disarmyouwitha/zenR4-pcb/projects/README.md

# Active project: Nano Independent

The owner is pursuing a spare original PCB from Darryl for the Zen repair. Integrated replacement development is set aside. Our active design is a nice!nano keyboard and a new case, inspired by the Zen geometry.

- **[Draft B — actual routed boards, revised outline](nano-independent/draft-b/README.md)**
- [Nice!nano project direction](nano-independent/README.md)
- [Current ChatGPT handoff](../docs/CHATGPT-HANDOFF.md)
- [Shared future flash/RGB/display plan](shared/FEATURES.md)

Draft A remains unchanged under `../r4-layout/` and tag `draft-a-baseline`. Draft B changes the outer board edges only; it does not claim the new display/RGB circuitry or new case is finished.
