disarmyouwitha/zenR4-pcb/ATTRIBUTION.md

# Attribution and third-party material

- Original Corne-ish Zen CAD: Thingiverse user **darryldh**, https://www.thingiverse.com/thing:4698210 . The downloaded license states **Creative Commons — Attribution — Non-Commercial — No Derivatives**. Its supplied license and README are retained in `references/zen-original/`, with a copy under `LICENSES/`. Modified base files are personal prototype studies; this private backup does not assert permission for their public redistribution. Review the source terms before publishing this repository.
- KiCad standard footprints and the local `__NoSilk` derivatives: supplied KiCad libraries, with the library license and exception retained in `LICENSES/kicad-footprints-LICENSE.md`. Pad and courtyard geometry of these standard-footprint derivatives was retained; crowded silkscreen was removed.
- Choc socket reference shape: foostan/crkbd and associated kbd footprint sources. Retained reference footprint and the downloaded source notices are under `r4-layout/evidence/`. This project uses a custom Choc V1 socket pattern and derived courtyard; retain the supplied notices.
- Typeractive's model and pinout were earlier research references. This project does not claim Typeractive's PCB source was released or that these custom boards are that product.
- nice!nano/nice!view are referenced products of nice!keyboards; this is an independent carrier prototype.

No blanket license is assigned to all repository content. Source notices remain applicable to their respective files. Private visibility is the initial sharing setting, not an assertion of open-hardware licensing.
