disarmyouwitha/zenR4-pcb/docs/START-HERE.md

# Current packet: Draft-Corne C

Unpack `draft-corne.zip`. Upload `docs/CHATGPT-HANDOFF.md`, `projects/choc-corne-flash/draft-c/README.md`, `validation.json`, and `placement-preview.png` to the next ChatGPT conversation. Native KiCad schematics/boards and local libraries are included for detailed review.

Prompt: “Help review Draft-Corne: 42-key Choc Corne, our tested matrix, front-mounted nice!nanos with components down, left QSPI, right nice!view, battery solder pads on the back. Read the validation report; routing is complete and assembly fit remains unverified. Preserve the tested GPIO map.”

GitHub is private and another session may need uploaded files. Older A/B packets are historical.
