disarmyouwitha/zenR4-pcb/docs/images/01-layout-annotated.png

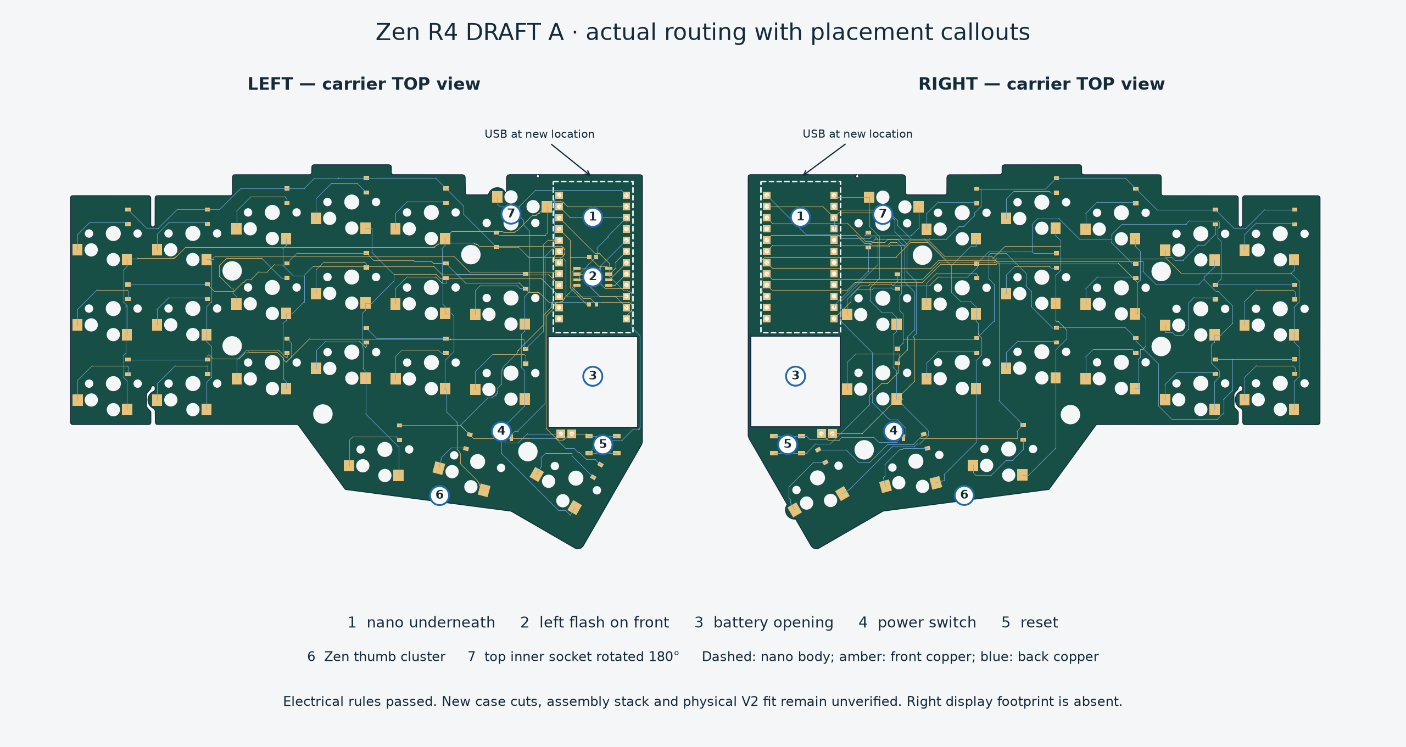
docs/images/01-layout-annotated.png
