disarmyouwitha/zenR4-pcb/docs/images/02-system-and-power.png

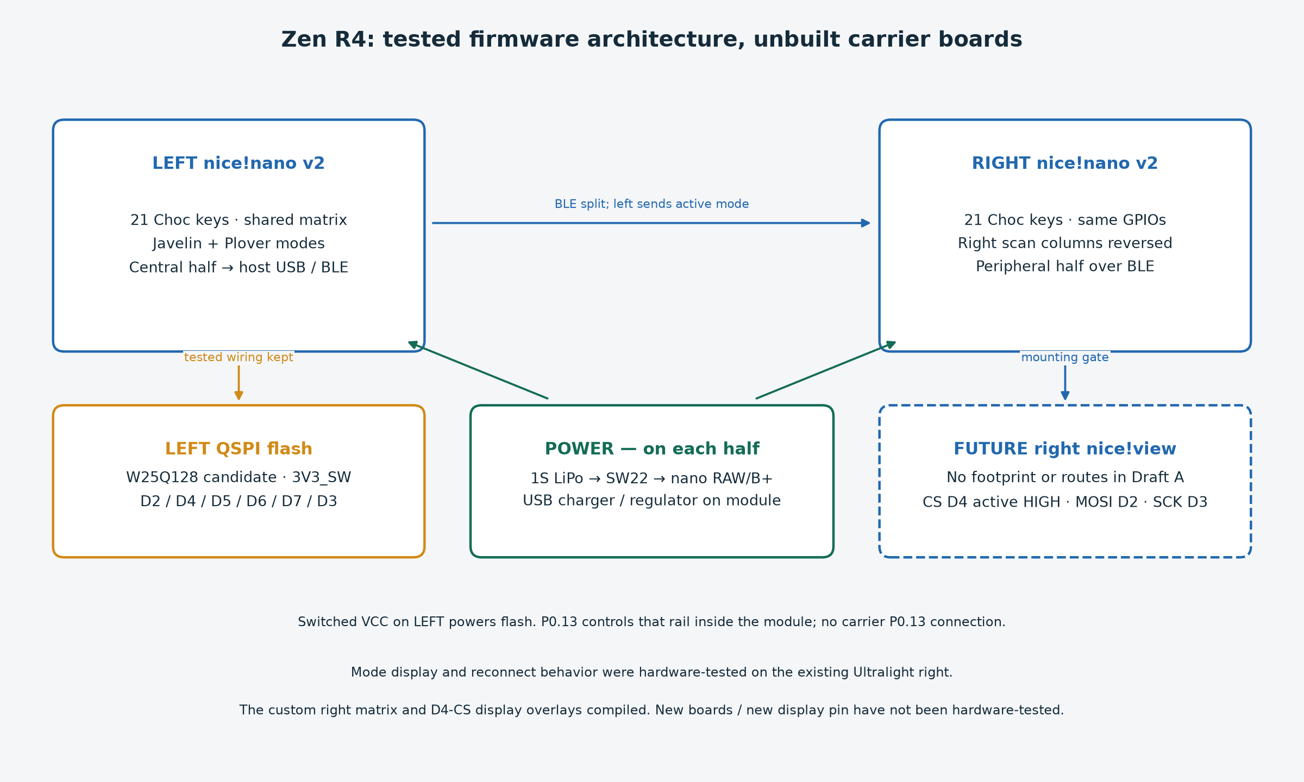
docs/images/02-system-and-power.png
