disarmyouwitha/zenR4-pcb/docs/images/03-nano-top-view-pinmap.png

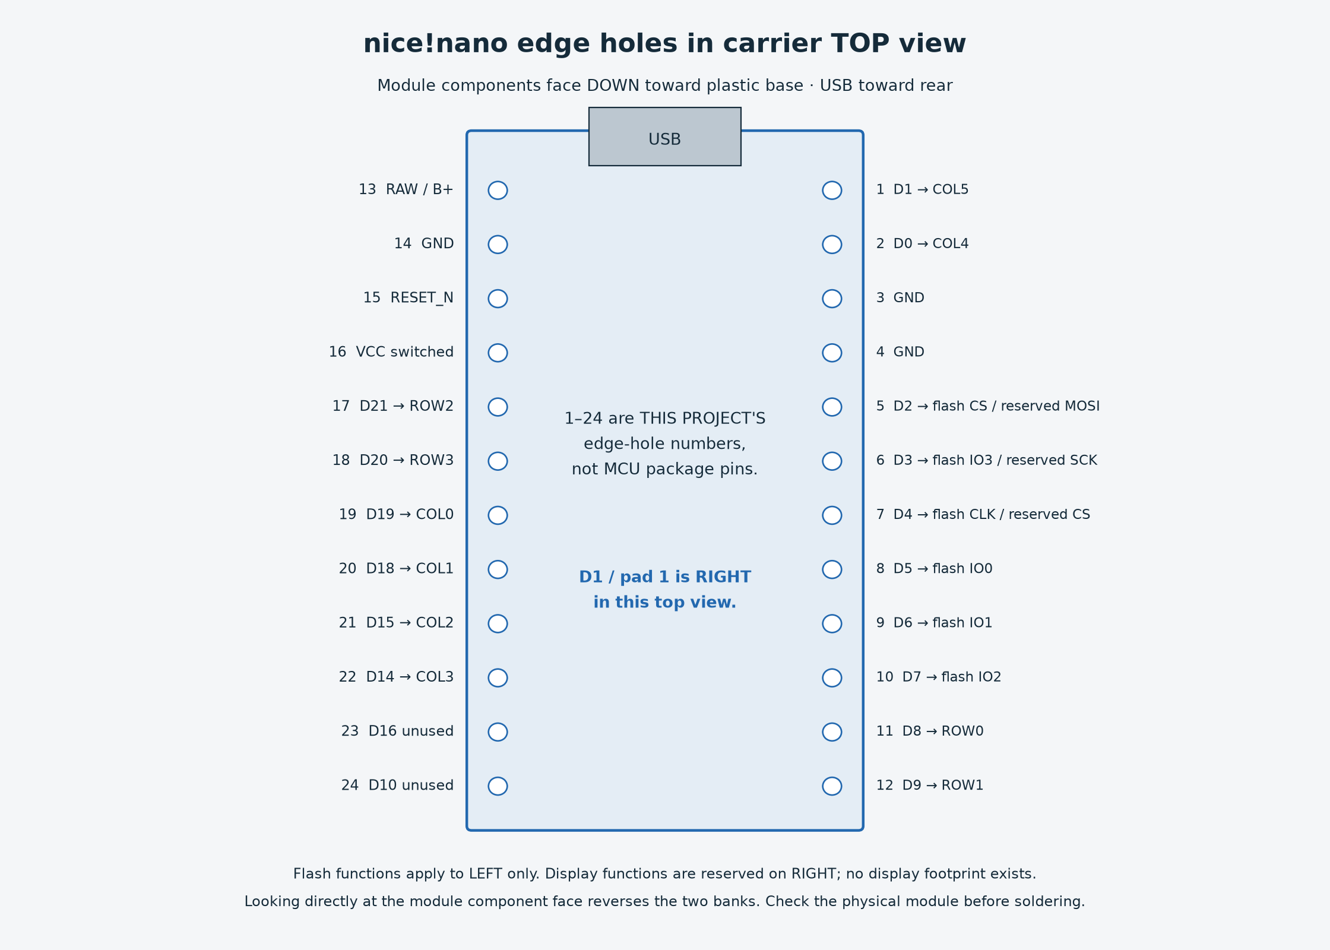
docs/images/03-nano-top-view-pinmap.png
