disarmyouwitha/zenR4-pcb/docs/images/left-controller-detail.png

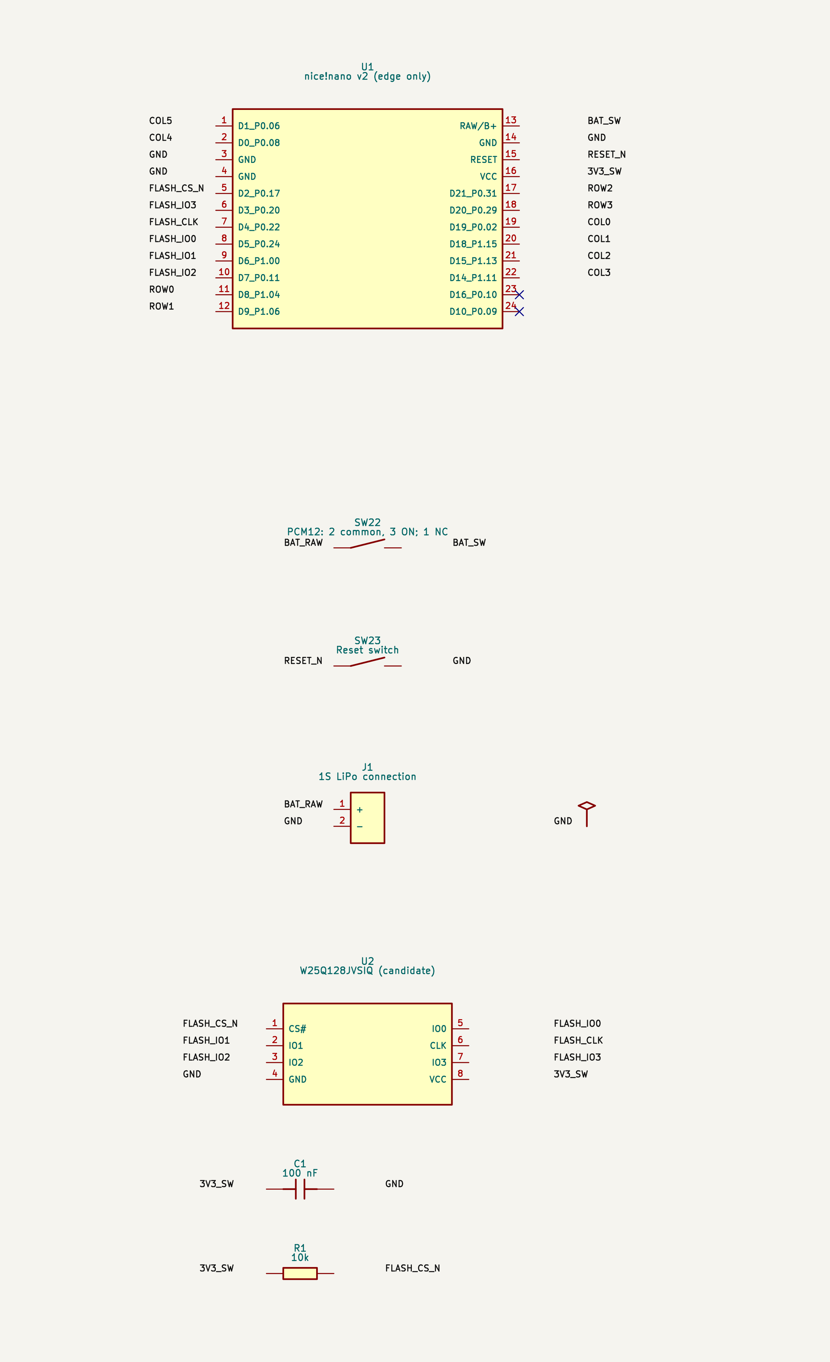
docs/images/left-controller-detail.png
