disarmyouwitha/zenR4-pcb/docs/images/left-schematic-full.png

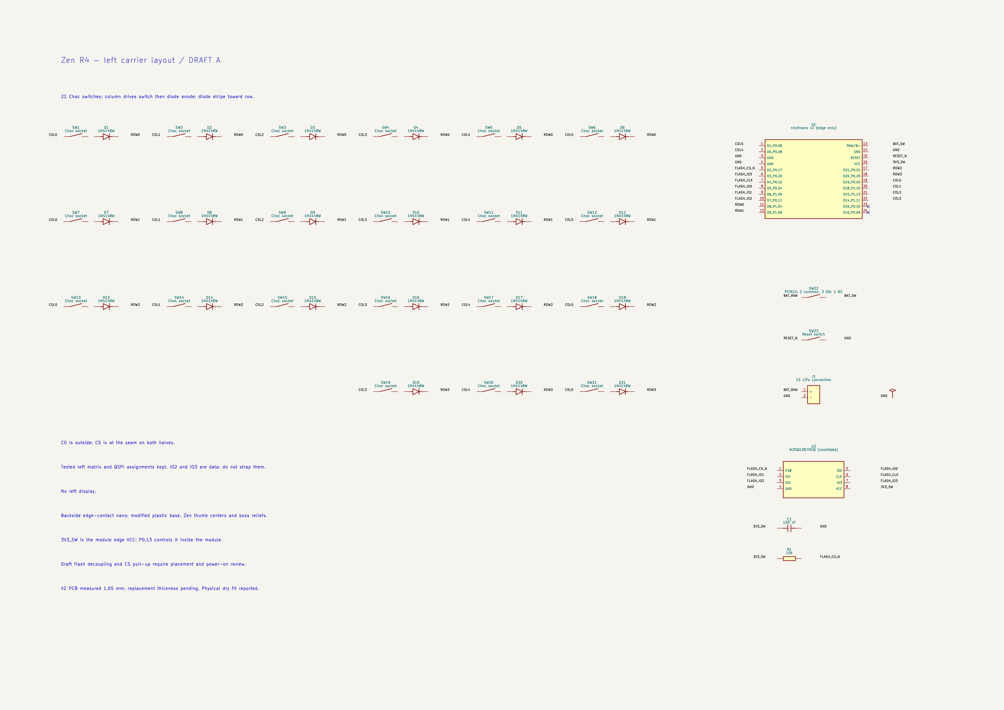
docs/images/left-schematic-full.png
