disarmyouwitha/zenR4-pcb/docs/images/right-controller-detail.png

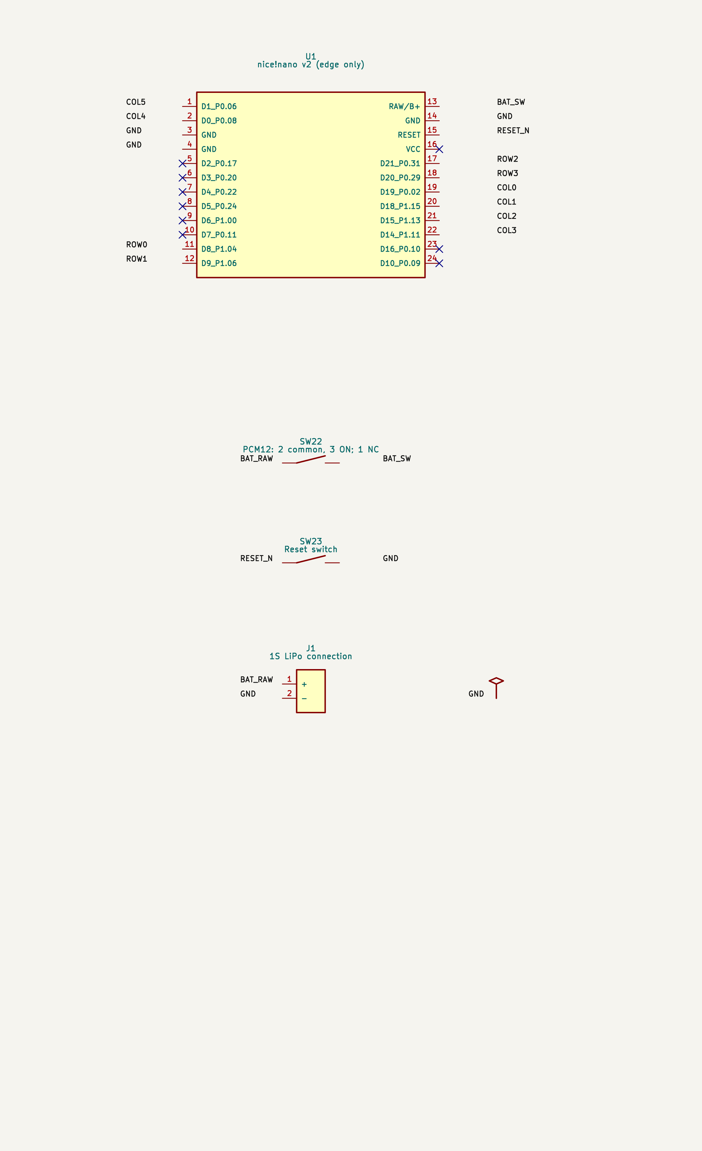
docs/images/right-controller-detail.png
