disarmyouwitha/zenR4-pcb/docs/images/right-schematic-full.png

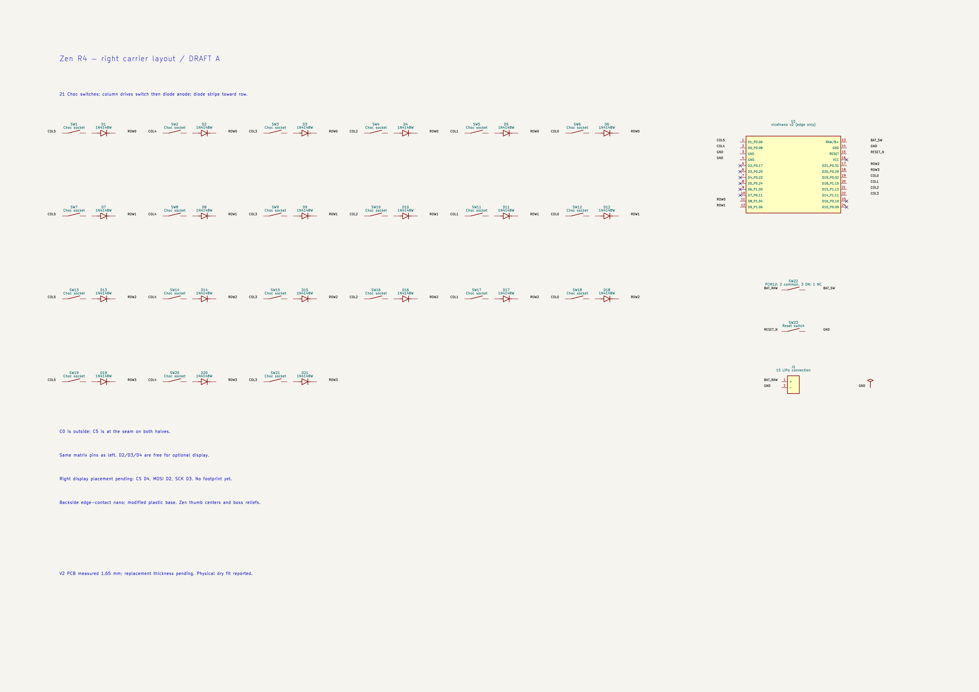
docs/images/right-schematic-full.png
