disarmyouwitha/zenR4-pcb/projects/steno-squid/draft-0/schematic-preview.png

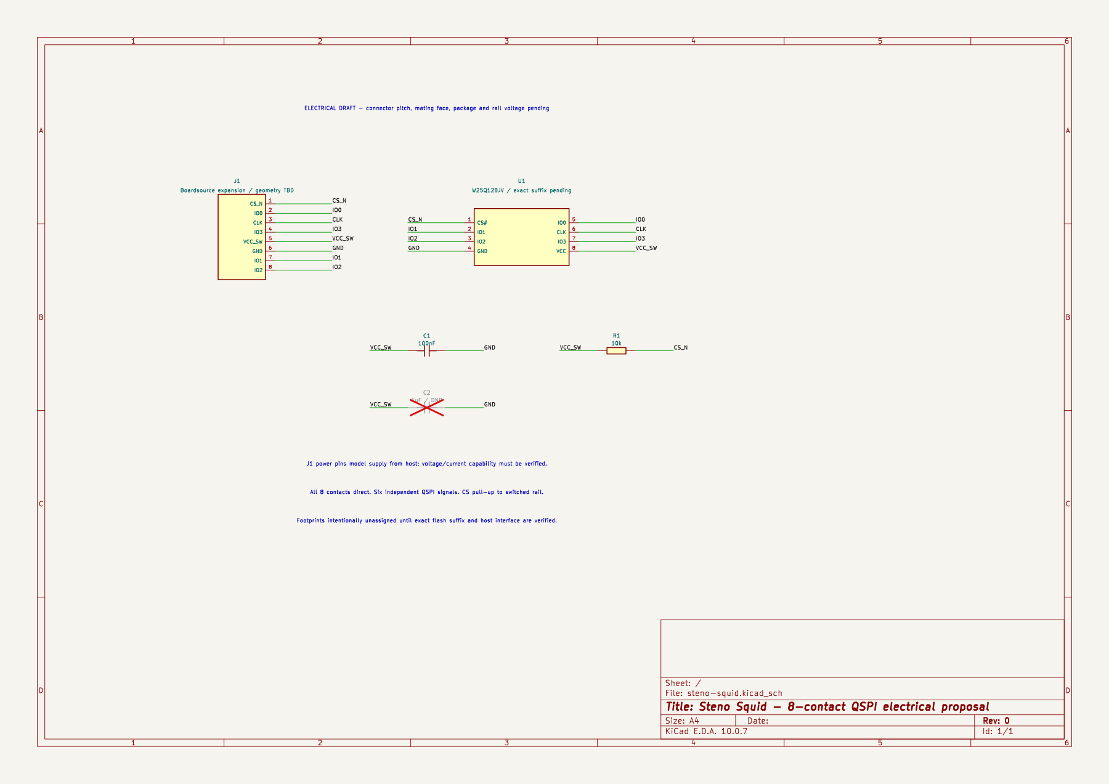
projects/steno-squid/draft-0/schematic-preview.png
