disarmyouwitha/zenR4-pcb/r4-layout/layout-preview.png

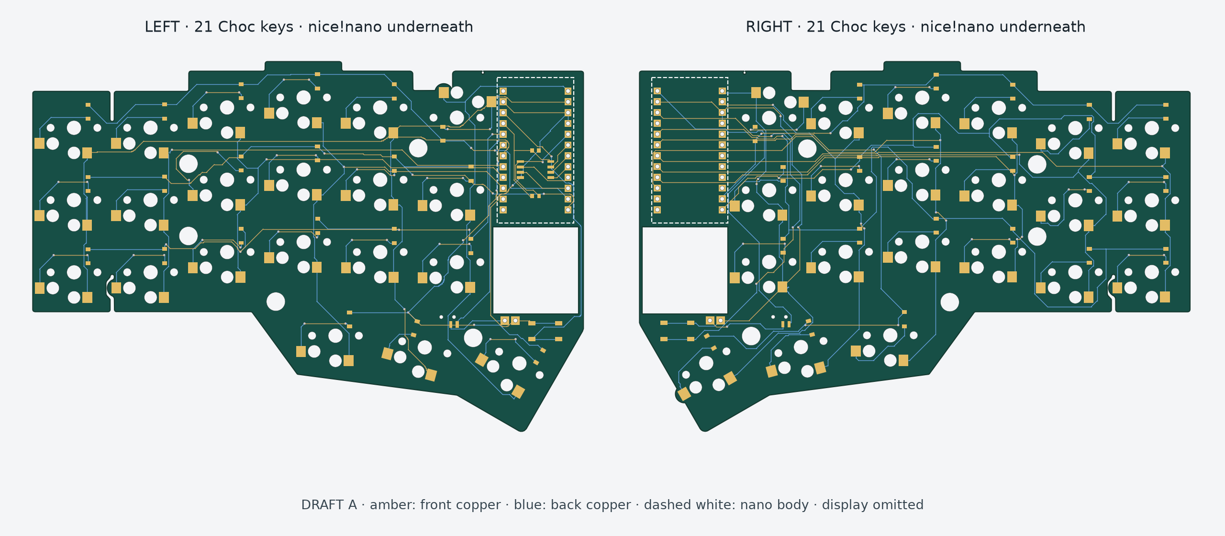
r4-layout/layout-preview.png
