disarmyouwitha/zenR4-pcb/references/zen-original/Corne-ish_Zen_3x6_main_case_left.stl

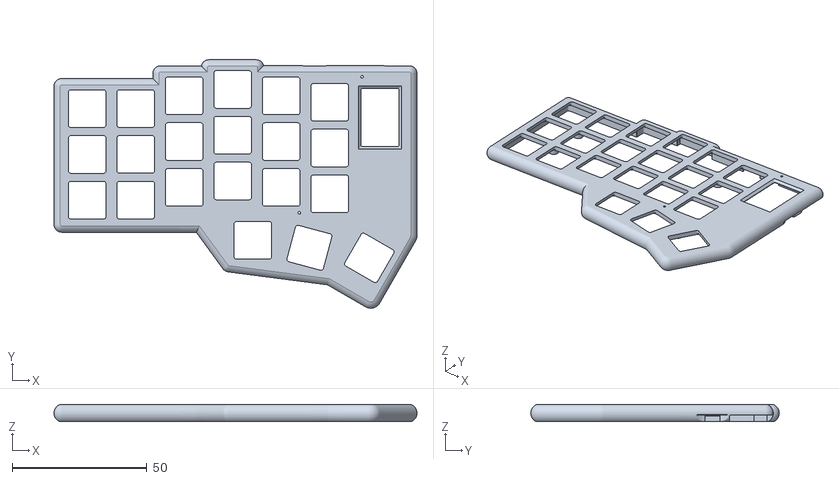
[picture p13: CAD file, 2026-11-09]
references/zen-original/Corne-ish_Zen_3x6_main_case_left.stl
134.8 x 92.3 x 6.39
