disarmyouwitha/zenR4-pcb/references/zen-original/Corne-ish_Zen_3x6_main_case_right.stl

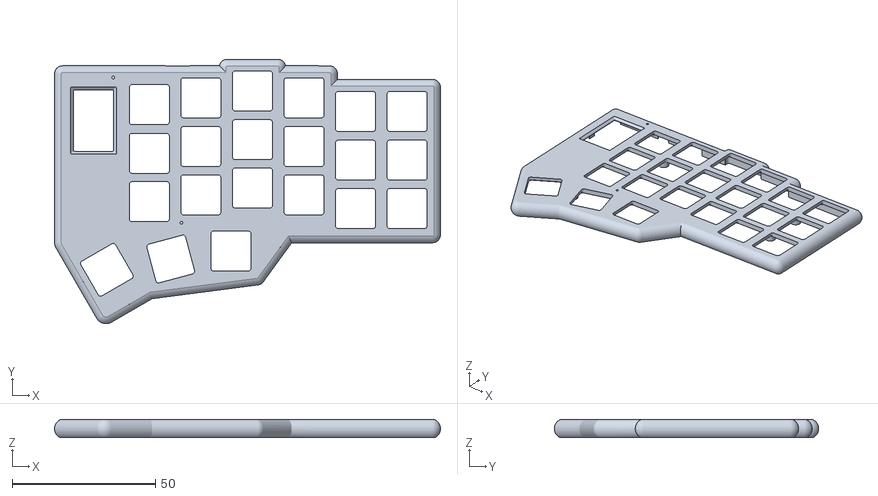
[picture p14: CAD file, 2026-11-09]
references/zen-original/Corne-ish_Zen_3x6_main_case_right.stl
134.7 x 92.3 x 6.39
