disarmyouwitha/zenR4-pcb/projects/nano-independent/draft-b/mechanical/nano-b-left-bare-pcb-PROTOTYPE.stl

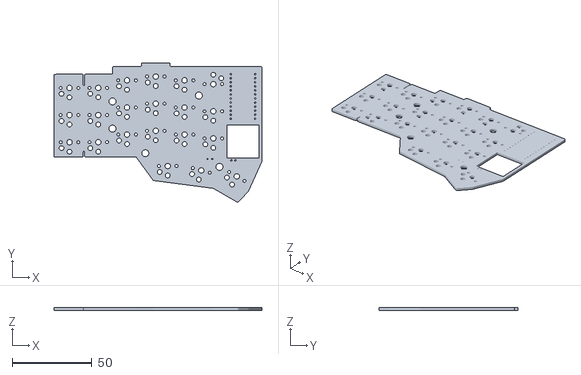
[picture p15: CAD file, 2026-11-10]
projects/nano-independent/draft-b/mechanical/nano-b-left-bare-pcb-PROTOTYPE.stl
130.2 x 87.0 x 1.60
