disarmyouwitha/zenR4-pcb/references/zen-original/Corne-ish_Zen_3x6_bottomplate_right.stl

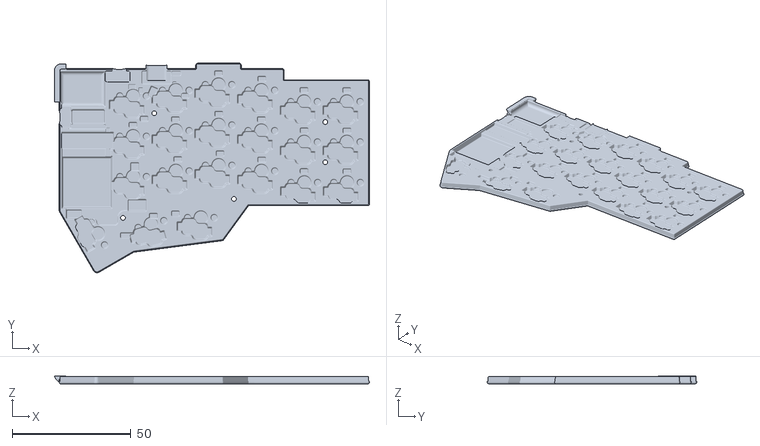
[picture p16: CAD file, 2026-11-09]
references/zen-original/Corne-ish_Zen_3x6_bottomplate_right.stl
132.6 x 88.2 x 3.40
