disarmyouwitha/zenR4-pcb/r4-layout/mechanical/zen-r4-left-base-pocket-PROTOTYPE.stl

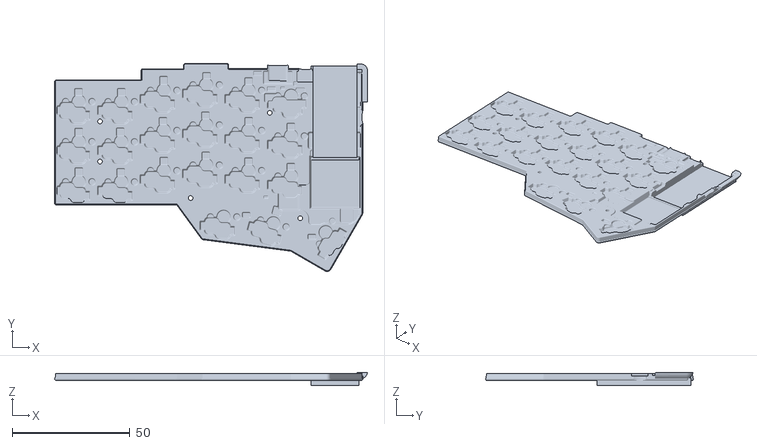
[picture p17: CAD file, 2026-11-09]
r4-layout/mechanical/zen-r4-left-base-pocket-PROTOTYPE.stl
132.7 x 88.2 x 5.33
