disarmyouwitha/zenR4-pcb/references/zen-original/Corne-ish_Zen_-_PCBs_v1.stl

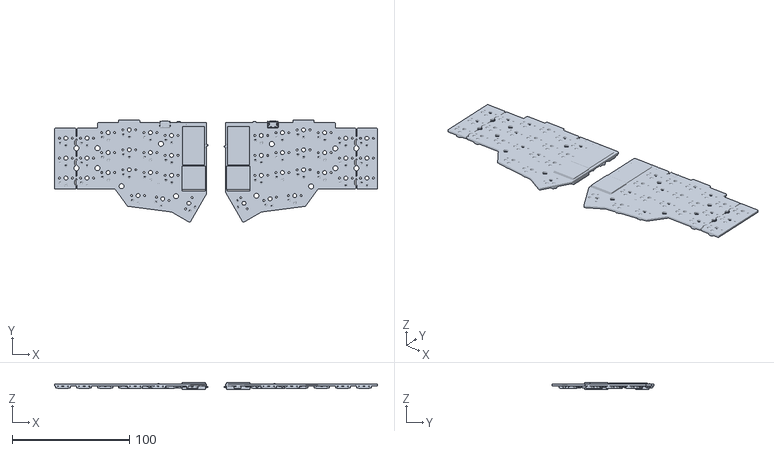
[picture p18: CAD file, 2026-11-09]
references/zen-original/Corne-ish_Zen_-_PCBs_v1.stl
275.2 x 87.0 x 6.25
