disarmyouwitha/zenR4-pcb/(list of files, cad)

Other CAD files:
r4-layout/mechanical/zen-r4-left-bare-pcb-fit-PROTOTYPE.stl
projects/nano-independent/draft-b/mechanical/nano-b-right-bare-pcb-PROTOTYPE.stl
references/zen-original/Corne-ish_Zen_3x6_bottomplate_left.stl
r4-layout/mechanical/zen-r4-right-bare-pcb-fit-PROTOTYPE.stl
r4-layout/mechanical/zen-r4-right-base-pocket-PROTOTYPE.stl
