disarmyouwitha/zenR4-pcb/projects/choc-corne-flash/reference/reconstruction-preview.png

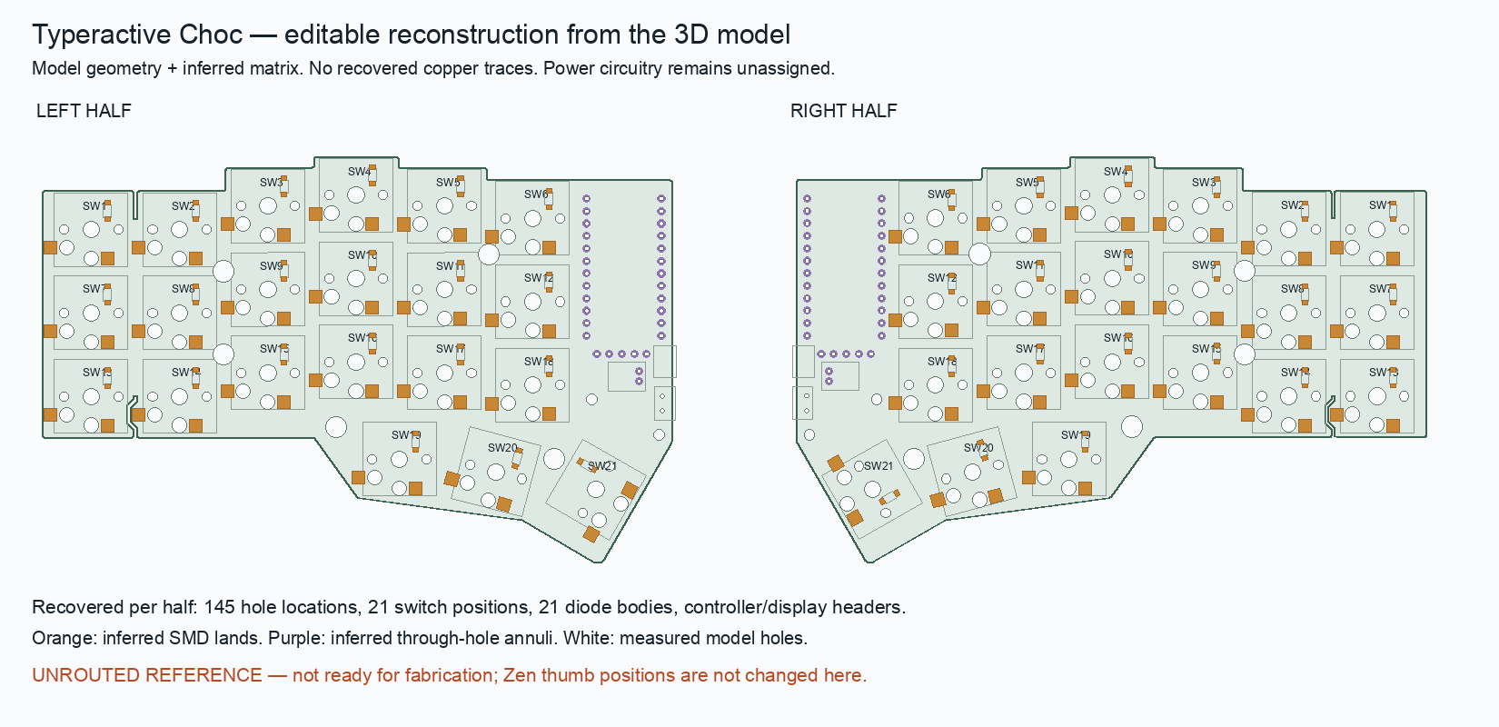
projects/choc-corne-flash/reference/reconstruction-preview.png
