disarmyouwitha/zenR4-pcb/(list of files, drawings)

Other design files:
projects/choc-corne-flash/draft-c/draft-corne-left.dsn
projects/choc-corne-flash/draft-c/draft-corne-right.dsn
projects/choc-corne-flash/draft-c/schematic-links.json
r4-layout/schematic-links.json
r4-layout/zen-r4-left-continue.dsn
r4-layout/zen-r4-left.dsn
r4-layout/zen-r4-right-continue.dsn
r4-layout/zen-r4-right.dsn
