disarmyouwitha/zenR4-pcb/projects/choc-corne-flash/draft-c/draft-corne-right.kicad_pcb

## KiCad design projects/choc-corne-flash/draft-c/draft-corne-right.kicad_pcb (2026-11-10)

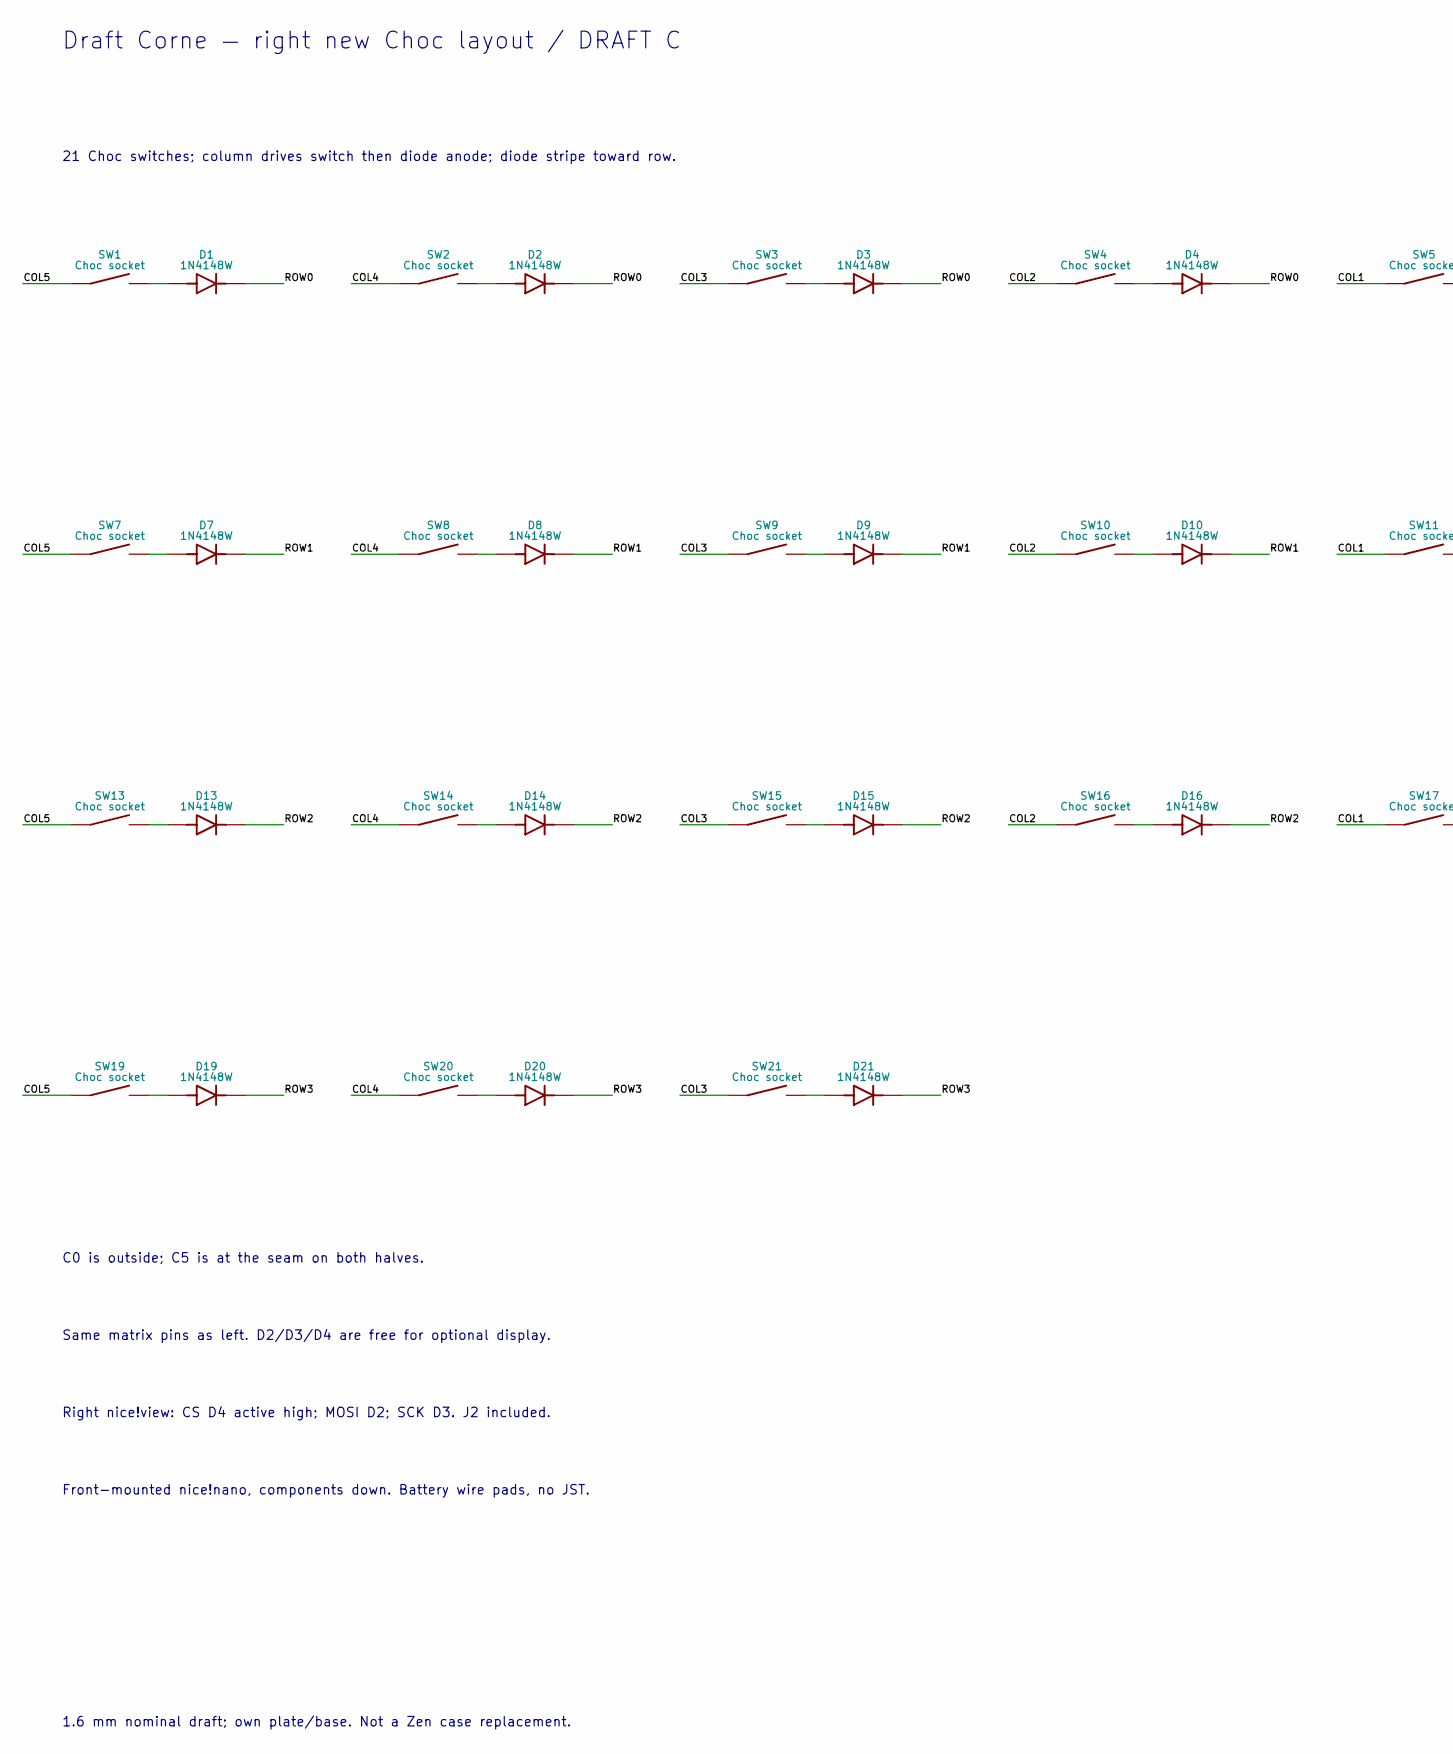
[picture p20: schematic draft-corne-right.kicad_sch, Draft Corne right, part in row 1, column 1]

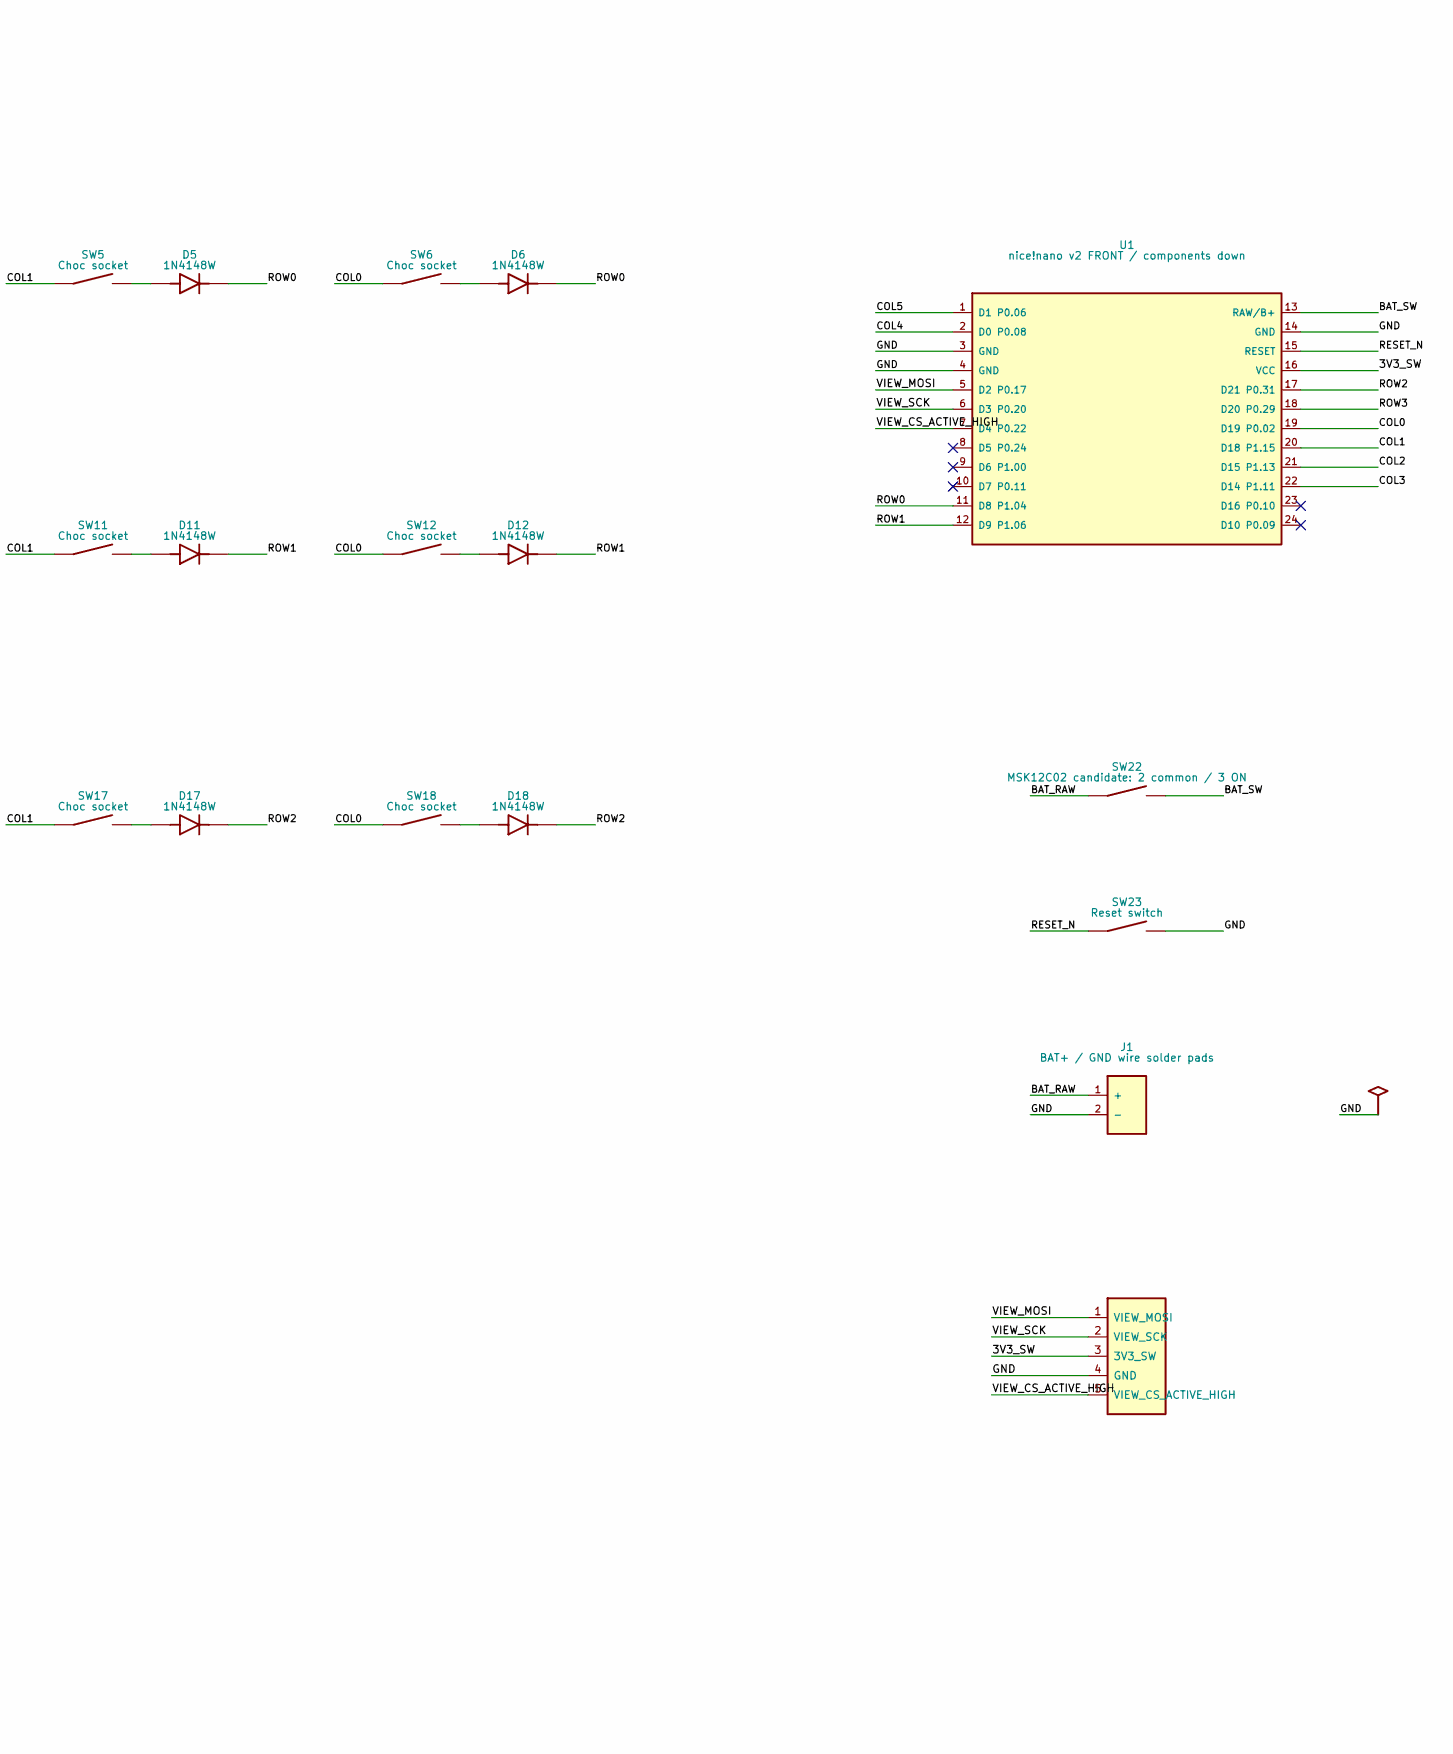
[picture p21: schematic draft-corne-right.kicad_sch, Draft Corne right, part in row 1, column 2]

Parts:
D1, D2, D3, D4, D5, D6, D7, D8, D9, D10, D11, D12, D13, D14, D15, D16, D17, D18, D19, D20, D21: 1N4148W; Diode_SOD123_Bottom
J1: BAT+ / GND wire solder pads; Battery_Wire_SMD
J2: nice!view front header; NiceView_Front_Header
SW1, SW2, SW3, SW4, SW5, SW6, SW7, SW8, SW9, SW10, SW11, SW12, SW13, SW14, SW15, SW16, SW17, SW18, SW19, SW20, SW21: Choc socket; ChocSocket_Bottom
SW22: MSK12C02 candidate: 2 common / 3 ON; Power_MSK12C02
SW23: Reset switch; Reset_TL3342
U1: nice!nano v2 FRONT / components down; Nano_Front_Down

Connections:
/3V3_SW: J2.3 (3V3_SW), U1.16 (VCC)
/BAT_RAW: J1.1 (+), SW22.2 (1)
/BAT_SW: SW22.3 (2), U1.13 (RAW/B+)
/COL0: SW6.1, SW12.1, SW18.1, U1.19 (D19 P0.02)
/COL1: SW5.1, SW11.1, SW17.1, U1.20 (D18 P1.15)
/COL2: SW4.1, SW10.1, SW16.1, U1.21 (D15 P1.13)
/COL3: SW3.1, SW9.1, SW15.1, SW21.1, U1.22 (D14 P1.11)
/COL4: SW2.1, SW8.1, SW14.1, SW20.1, U1.2 (D0 P0.08)
/COL5: SW1.1, SW7.1, SW13.1, SW19.1, U1.1 (D1 P0.06)
/GND: J1.2 (-), J2.4 (GND), SW23.2, U1.3 (GND), U1.4 (GND), U1.14 (GND)
/RESET_N: SW23.1, U1.15 (RESET)
/ROW0: D1.1 (K), D2.1 (K), D3.1 (K), D4.1 (K), D5.1 (K), D6.1 (K), U1.11 (D8 P1.04)
/ROW1: D7.1 (K), D8.1 (K), D9.1 (K), D10.1 (K), D11.1 (K), D12.1 (K), U1.12 (D9 P1.06)
/ROW2: D13.1 (K), D14.1 (K), D15.1 (K), D16.1 (K), D17.1 (K), D18.1 (K), U1.17 (D21 P0.31)
/ROW3: D19.1 (K), D20.1 (K), D21.1 (K), U1.18 (D20 P0.29)
/VIEW_CS_ACTIVE_HIGH: J2.5 (VIEW_CS_ACTIVE_HIGH), U1.7 (D4 P0.22)
/VIEW_MOSI: J2.1 (VIEW_MOSI), U1.5 (D2 P0.17)
/VIEW_SCK: J2.2 (VIEW_SCK), U1.6 (D3 P0.20)
unnamed: D1.2 (A), SW1.2
unnamed: D2.2 (A), SW2.2
unnamed: D3.2 (A), SW3.2
unnamed: D4.2 (A), SW4.2
unnamed: D5.2 (A), SW5.2
unnamed: D6.2 (A), SW6.2
unnamed: D7.2 (A), SW7.2
unnamed: D8.2 (A), SW8.2
unnamed: D9.2 (A), SW9.2
unnamed: D10.2 (A), SW10.2
unnamed: D11.2 (A), SW11.2
unnamed: D12.2 (A), SW12.2
unnamed: D13.2 (A), SW13.2
unnamed: D14.2 (A), SW14.2
unnamed: D15.2 (A), SW15.2
unnamed: D16.2 (A), SW16.2
unnamed: D17.2 (A), SW17.2
unnamed: D18.2 (A), SW18.2
unnamed: D19.2 (A), SW19.2
unnamed: D20.2 (A), SW20.2
unnamed: D21.2 (A), SW21.2

Notes on the sheet:
Draft Corne — right new Choc layout / DRAFT C
21 Choc switches; column drives switch then diode anode; diode stripe toward row.
C0 is outside; C5 is at the seam on both halves.
Same matrix pins as left. D2/D3/D4 are free for optional display.
Right nice!view: CS D4 active high; MOSI D2; SCK D3. J2 included.
Front-mounted nice!nano, components down. Battery wire pads, no JST.
1.6 mm nominal draft; own plate/base. Not a Zen case replacement.

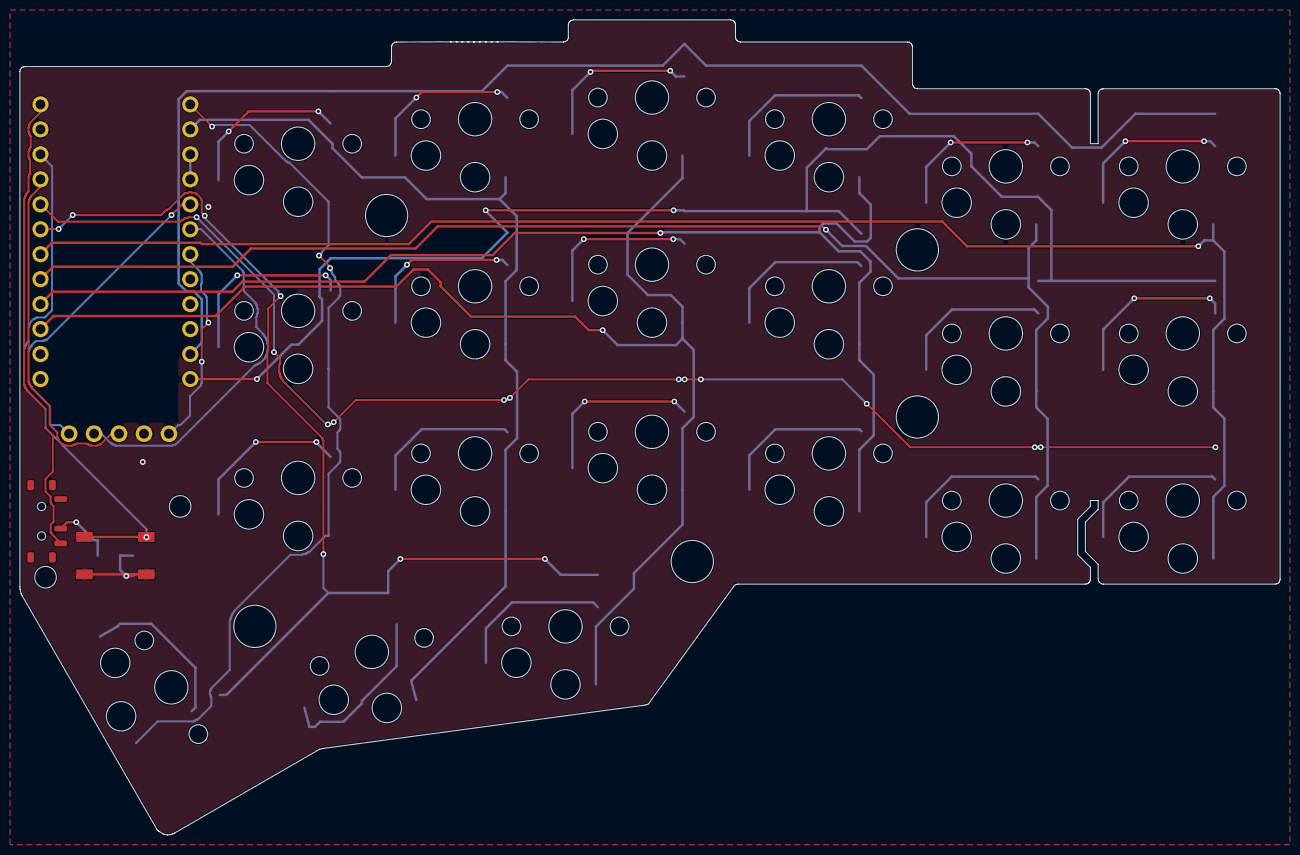
[picture p22: board draft-corne-right.kicad_pcb from above]

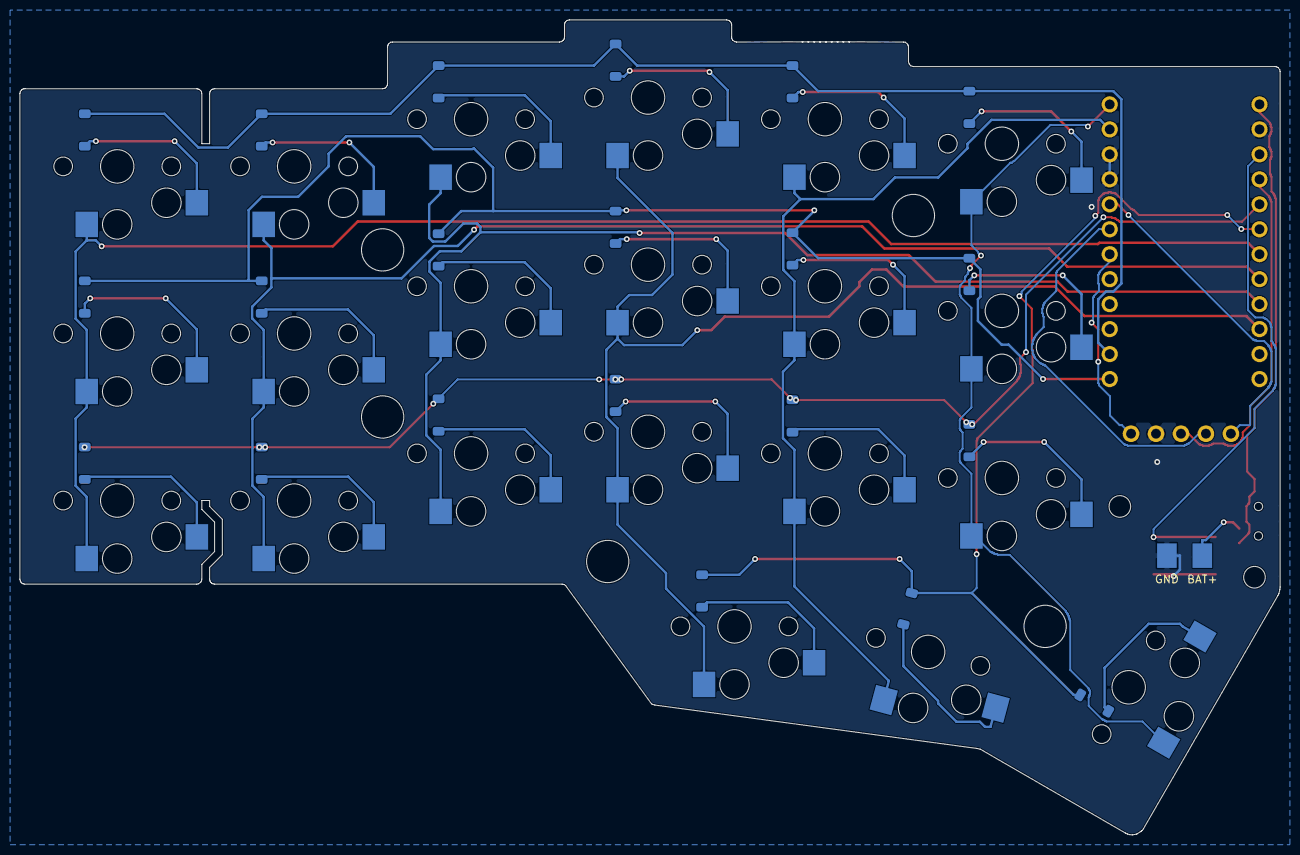
[picture p23: board draft-corne-right.kicad_pcb from below]

Board: 2 copper layers, 128.2 x 82.9 mm, 54 parts (43 on the bottom side), 39 nets.

Other parts of the board:
H1, H2, H3, H4, H6: Mount_4p3
H5, H7: Mount_2p2
