disarmyouwitha/zenR4-pcb/projects/steno-squid/draft-0/steno-squid.kicad_sch

## KiCad design projects/steno-squid/draft-0/steno-squid.kicad_sch (2026-11-11)

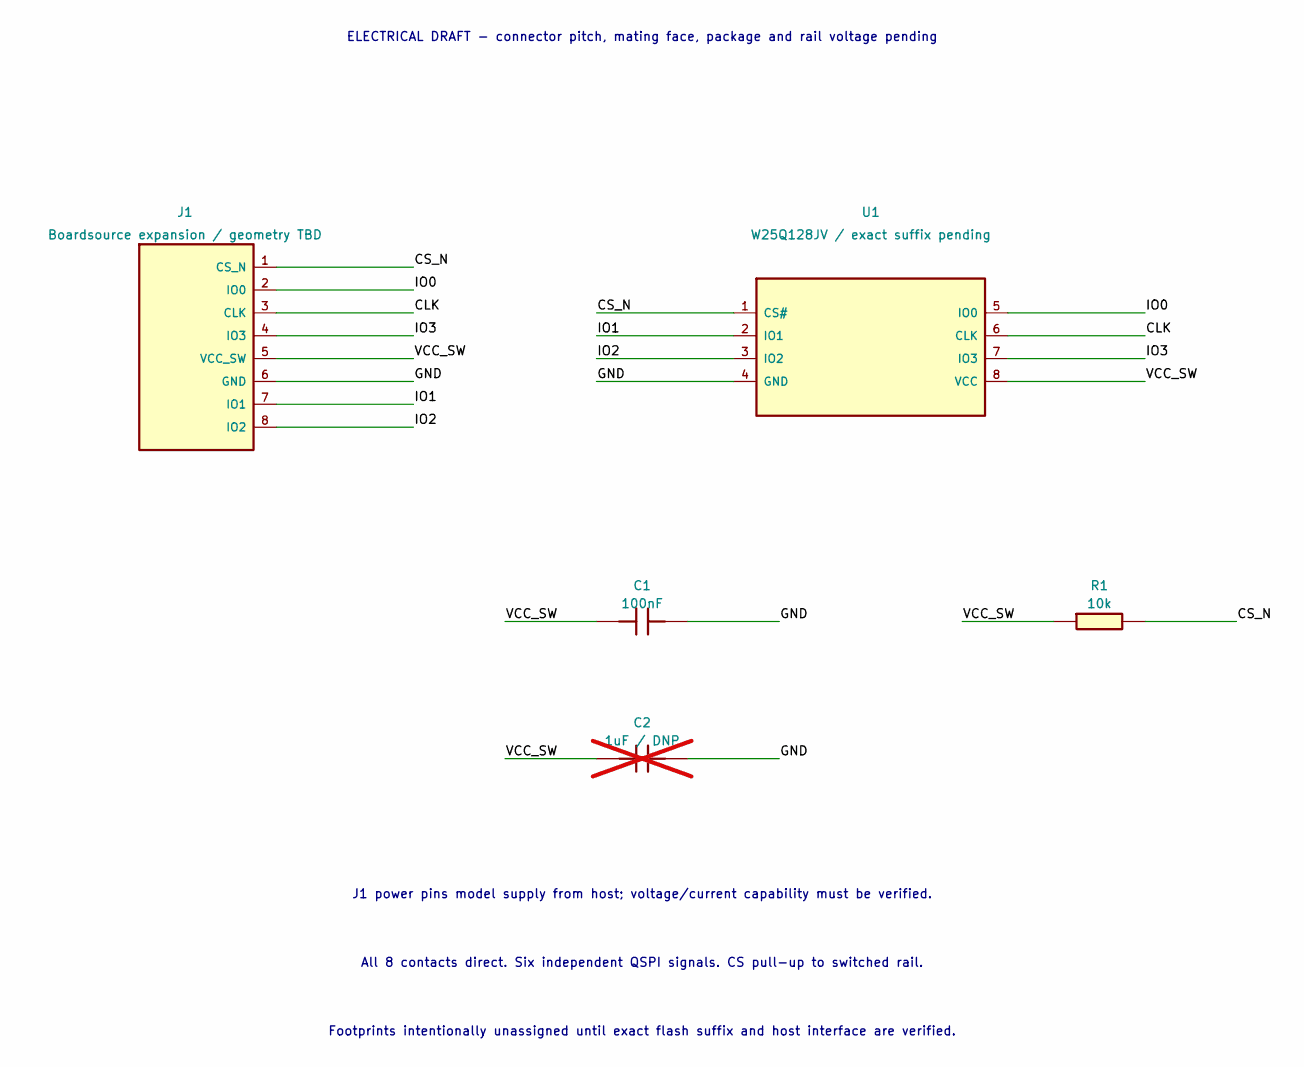
[picture p24: schematic steno-squid.kicad_sch]

Parts:
C1: 100nF
C2: 1uF / DNP; not fitted
J1: Boardsource expansion / geometry TBD
R1: 10k
U1: W25Q128JV / exact suffix pending

Connections:
CLK: J1.3 (CLK), U1.6 (CLK)
CS_N: J1.1 (CS_N), R1.2, U1.1 (CS#)
GND: C1.2, C2.2, J1.6 (GND), U1.4 (GND)
IO0: J1.2 (IO0), U1.5 (IO0)
IO1: J1.7 (IO1), U1.2 (IO1)
IO2: J1.8 (IO2), U1.3 (IO2)
IO3: J1.4 (IO3), U1.7 (IO3)
VCC_SW: C1.1, C2.1, J1.5 (VCC_SW), R1.1, U1.8 (VCC)

Notes on the sheet:
ELECTRICAL DRAFT - connector pitch, mating face, package and rail voltage pending
J1 power pins model supply from host; voltage/current capability must be verified.
All 8 contacts direct. Six independent QSPI signals. CS pull-up to switched rail.
Footprints intentionally unassigned until exact flash suffix and host interface are verified.
