disarmyouwitha/zenR4-pcb/(commit log)

2026-11-09 Add checked Zen R4 PCB prototype and ChatGPT handoff
    [Corne-ish_Zen_-_PCBs_v1.stl, Corne-ish_Zen_3x6_bottomplate_left.stl, Corne-ish_Zen_3x6_bottomplate_right.stl, Corne-ish_Zen_3x6_main_case_left.stl, Corne-ish_Zen_3x6_main_case_right.stl, schematic-links.json, zen-r4-left-bare-pcb-fit-PROTOTYPE.stl, zen-r4-left-base-pocket-PROTOTYPE.stl]
2026-11-10 Add nano Draft B with flat rear edge and mirrored thumb contours
    [nano-b-left-bare-pcb-PROTOTYPE.stl, nano-b-right-bare-pcb-PROTOTYPE.stl, rgb-budget.csv, zen-r4-left.kicad_pcb, zen-r4-left.kicad_sch, zen-r4-right.kicad_pcb, zen-r4-right.kicad_sch]
2026-11-10 Narrow target to Typeractive-style Choc Corne with left flash and right view
    [component-placement.csv, typeractive-model-left.kicad_pcb, typeractive-model-left.kicad_sch, typeractive-model-right.kicad_pcb, typeractive-model-right.kicad_sch]
2026-11-10 Start Draft-Corne with front-mounted nanos, left QSPI and right niceview
    [draft-corne-left.dsn, draft-corne-left.kicad_pcb, draft-corne-left.kicad_sch, draft-corne-right.dsn, draft-corne-right.kicad_pcb, draft-corne-right.kicad_sch, schematic-links.json]
2026-11-10 Finish Draft-Corne routing and ground planes
    [draft-corne-left.kicad_pcb, draft-corne-right.kicad_pcb]
2026-11-11 Start Steno Squid eight-contact QSPI electrical proposal
    [steno-squid.kicad_sch]
